iotbits-us/mbox-hardware-mk/docs/README.md

# ModbusBox Hardware For Makers
ModbusBox device hardware design.

### Introduction.

**ModbusBox**    allows the integration of Modbus RTU networks to a WiFi connection. It is capable to  read data registers  from Modbus slaves (tested with 4 )  then send data periodically  to cloud services using the very popular MQTT protocol. Data is serialized  using  Json format , the information can be processed and displayed in dashboards  by many open source IOT platforms like Node-red, Influxdb & Grafana,  Ubidots educational and  its pay platform which is very powerfully and easy to use. 

**ModbusBox**  has been tested and optimized to be connected to  Variable frequency drives that uses  modbus RTU as base protocol , but it can be used with any other device that uses modbus rtu over RS485. protocol .

------

### Hardware features.

**Processor :** ESP32-WROOM-32 

**DC Input :** 7~ 26v ( step down dc buck regulator).

**Current consumption:** <100ma when DC input =20 ~27v

**Hardware interfaces.**

- 1x RS485 port (RJ45), non insolated.
- 1x programing connection (tx0/rx0).
- 1x SPI port.
- 1xI2c port.
- 3x micro buttons for ESP programing mode and device setup.

**Led indication.**

- 1x power led.
- 1 x MQTT activity ( msg send/received).
- 1x  Neopixel  RGB  led for device status indication.
- 1x Modbus TX led.
- 1x Modbus RX led.

**Additional Features**.

- Dc input voltage measurement (voltage divider connected to GPIO35).
- DC input capacitor act as short voltage backup , when  combined with the voltage divider measurement   can be used in the ESP32 program to send  and alarm ( for example an MQTT message )  before the voltage stored in the capacitor reach 3.3 volts.

**WiFi Specs**.

IEEE 802.11 b/g/n

Freq Band: 2.4 ~ 2.462 GHZ.

Integrated Antenna.

------

### PCB  DESING 

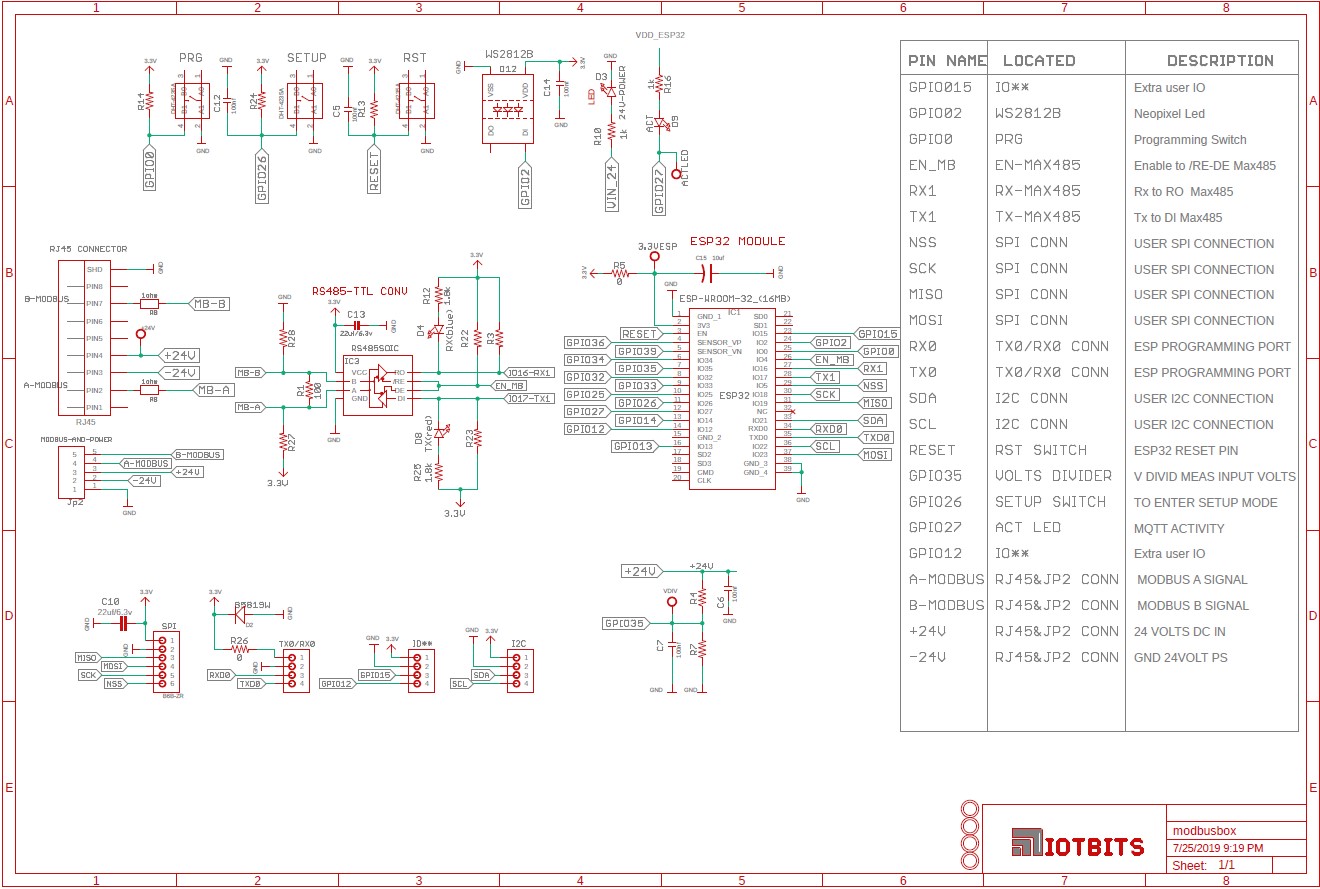
[picture p1: images/mboxschematic.jpg]
Electronic Schematic


[PDF SCHEMATIC](https://github.com/iotbits-llc/mbox-hardware-mk/blob/master/docs/modbusbox.pdf)

**Unassembled top layer  PCB photo**.

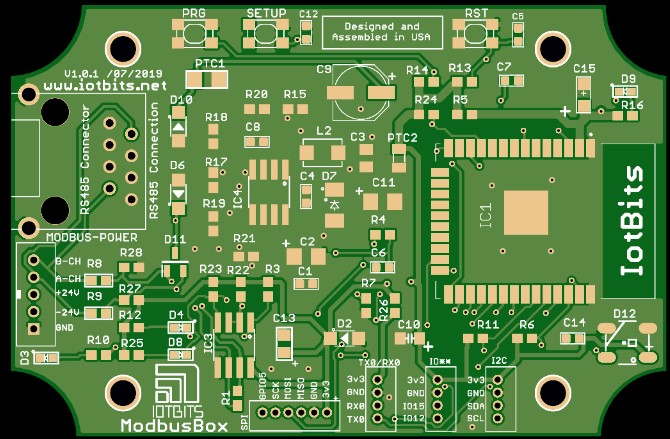
[picture p2: images/tpcb1.jpg]
TOP


**Unassembled bottom  layer  PCB photo**

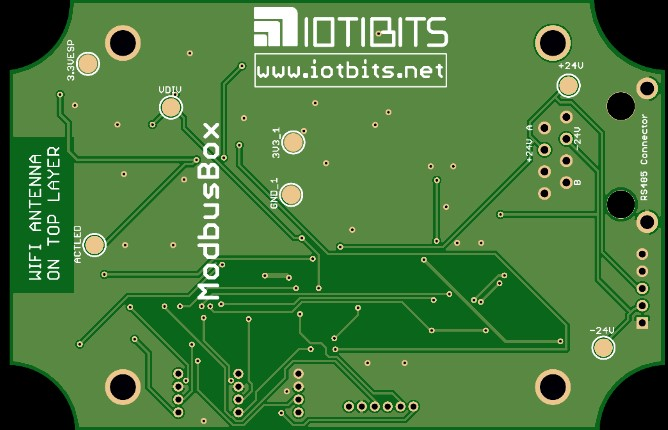
[picture p3: images/bpcb1.jpg]
Bottom


**PCB Photos** 

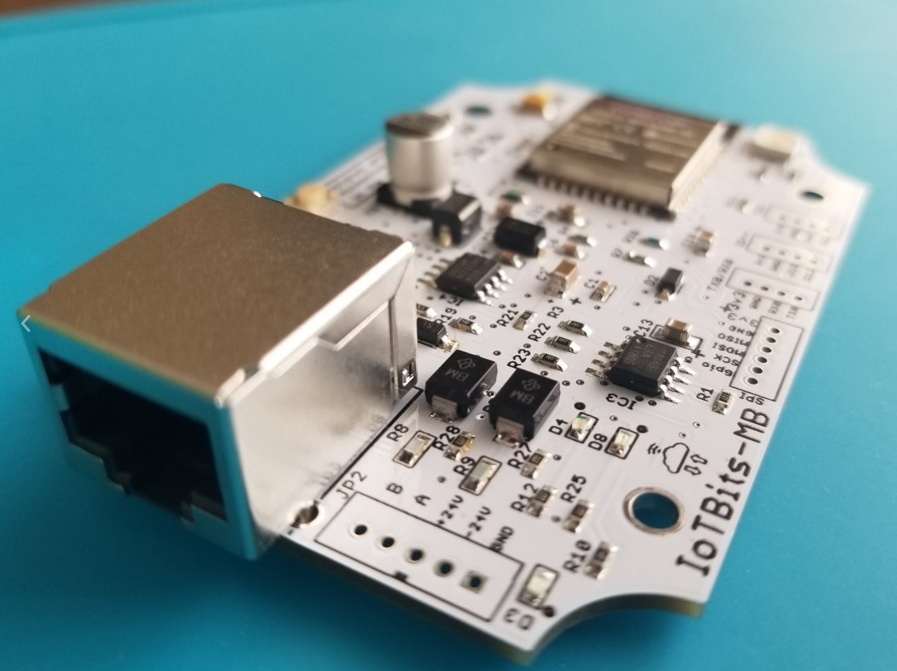
[picture p4: images/mbx2.jpg]
ASSEMBLED PCB


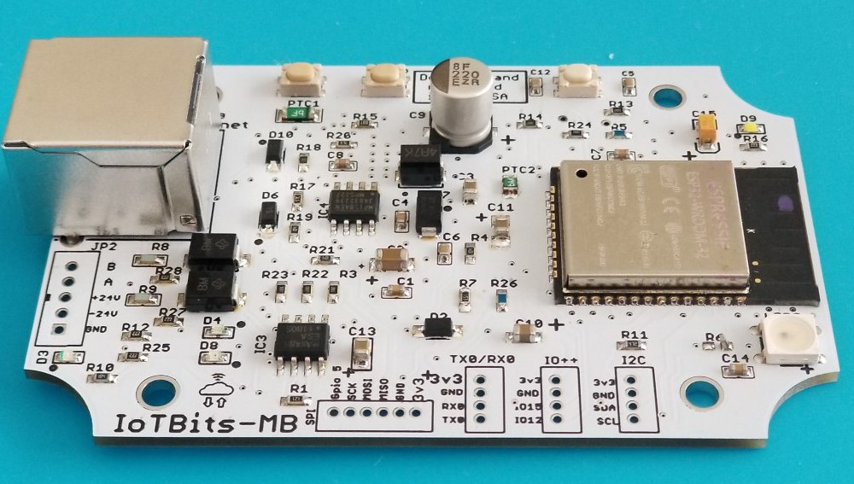
[picture p5: images/mbx3.jpg]


### Modbus  Box Assembled  

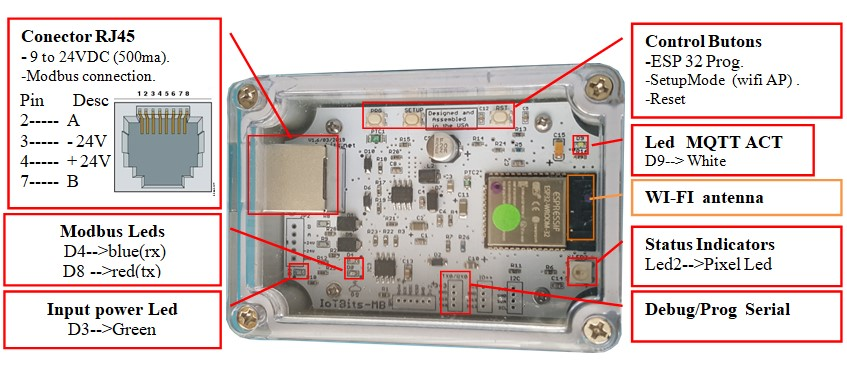
[picture p6: images/Mbox Connector.jpg]


------

###  Modbus Box & ControlTechniques AC drives.

The Modbus Box had been tested successfully  with several AC drives  models of the recognized brad Nidec Control techniques , some of the  drive models tested are : M200/300/400 and C200.  Modbus Box can be connected directly to the drive AI-485 adaptor which also have 24 volts , there is no requirement for additional power supply . An ethernet cable Cat5e  can be used to  make the connection  between the Modbus box and the drive RS485 port.

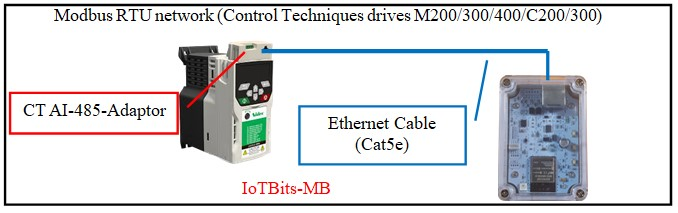
[picture p7: images/Mbox-CT drives.jpg]


------

### Connecting Modbus Box to other Modbus slaves.

In order to connect Modbus box to other Modbus slaves we recommend the following  connecting accessories  that can be found on eBay or Aliexpress.

- RJ45 Female To Screw Terminal 8 Pin Connector :  [ebay link](https://www.ebay.com/itm/RJ45-Female-To-Screw-Terminal-8-Pin-Connector-Ethernet-Cable-Extender-Adapter/254014714403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), [aliexpress link](https://www.aliexpress.com/item/32999037495.html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).
- Ethernet cable Cat6e 0.5m ...50m : [aliexpress link](https://www.aliexpress.com/item/32694241950.html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).
- DC 24 or 12 volts 1 amp  power supply : [aliexpress link ](https://www.aliexpress.com/item/33014882564.html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)

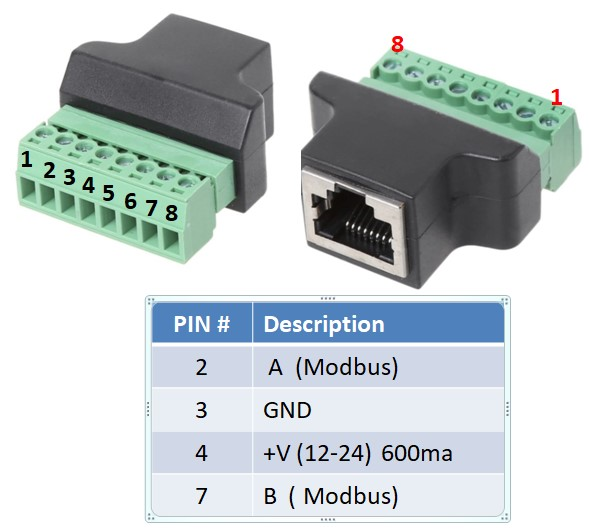
[picture p8: images/Modbus Adaptor.jpg]
RJ45 Female To Screw Terminal


### Connecting Modbus Box to SDM230-Modbus.

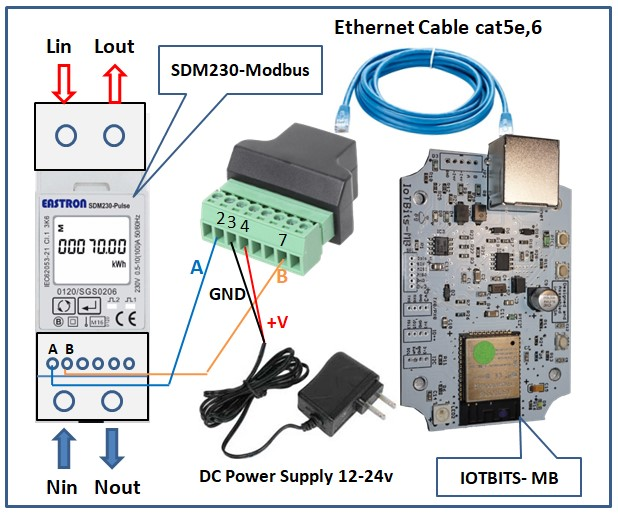
[picture p9: images/SDM230-Modbus.jpg]
SDM230-Modbus


[Library to test the ModbusBox ](https://github.com/luisgcu/SensorModbusMaster)
