iotbits-us/mbox-hardware-mk/images/mbx4.jpg

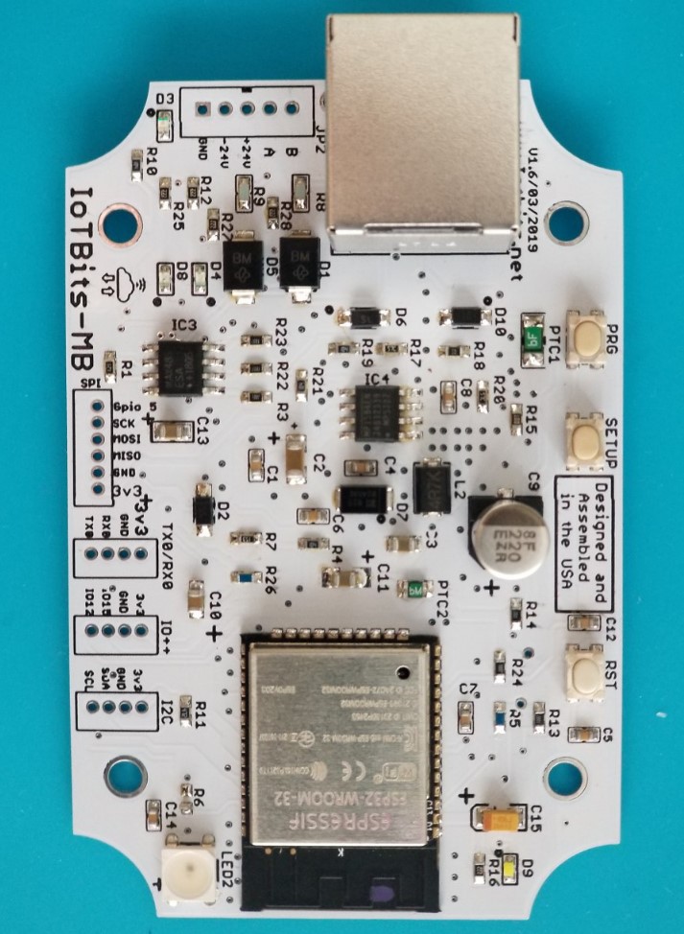
images/mbx4.jpg
