iotbits-us/mbox-hardware-mk/images/ModbusBox.png

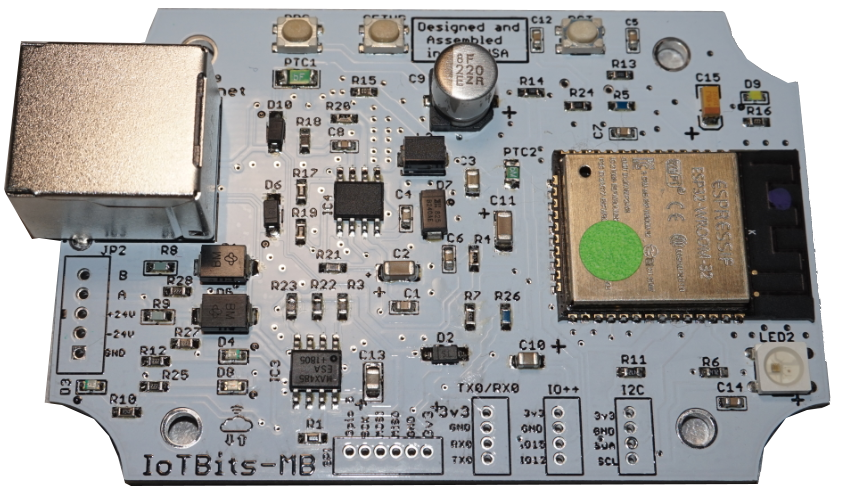
images/ModbusBox.png
