iotbits-us/mbox-hardware-mk/images/tpcb.jpg

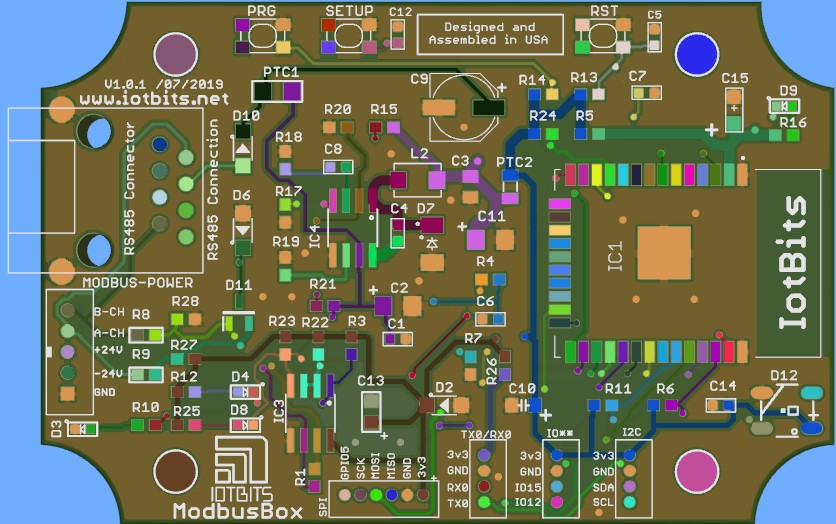
images/tpcb.jpg
