iotbits-us/mbox-hardware-mk/docs/modbusbox.pdf

# GND GND 3.3V GND 3.3V GND 3.3V

# 5 A⁰

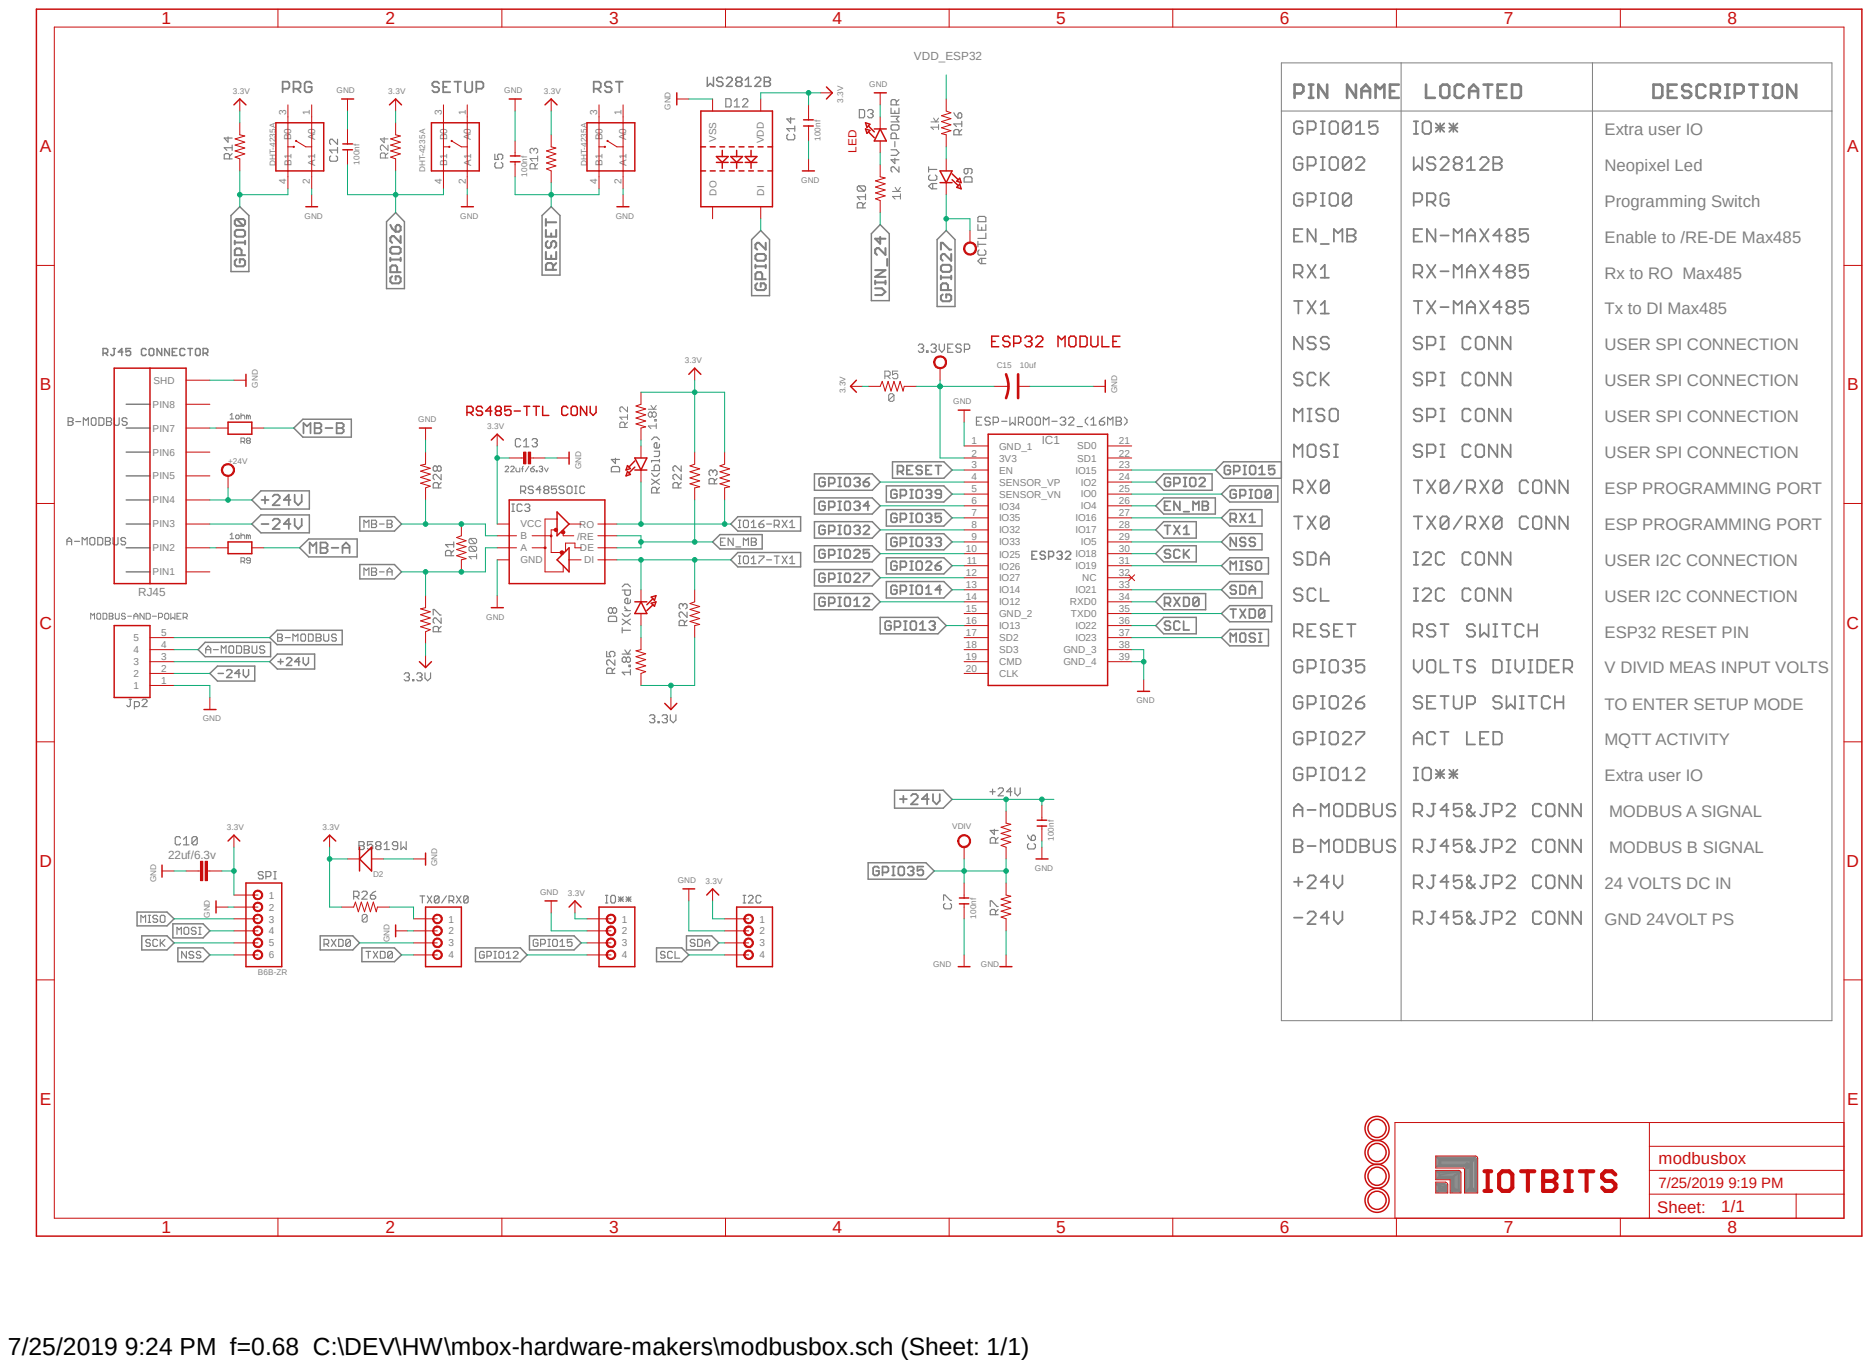
[picture p13: page 1]
GND; 3.3V GND GND; 3.3V GND; 22uf/6.3v GND; GND GND; 3.3V GND DHT⁻4235A; DHT⁻4235A 100nf GND 100nf; GND DHT⁻4235A; 100nf GND 100nf GND; 100nf GND; Neopixel Led; Programming Switch; USER I2C CONNECTION; ESP32 RESET PIN; MQTT ACTIVITY; MODBUS A SIGNAL; MODBUS B SIGNAL; 1 GND 24VOLT PS 2 3 4; DE GND; DI VCC; PIN1 PIN2 PIN3 PIN4 PIN5 PIN6 PIN7 PIN8 RJ45SHD; VSS; VDD DO; VDIV; GND_1 1; SENSOR_VP 4; SENSOR_VN 5; GND_2 15; CMD 19; CLK 20; 33 RXD0; 34 TXD0; 37 GND_3; 38 GND_4; VDD_ESP32 LED; Sheet: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

Extra user IO

Enable to /RE-DE Max485

Rx to RO Max485

Tx to DI Max485

USER SPI CONNECTION

ESP PROGRAMMING PORT

V DIVID MEAS INPUT VOLTS

TO ENTER SETUP MODE

24 VOLTS DC IN

7/25/2019 9:24 PM f=0.68 C:\DEV\HW\mbox-hardware-makers\modbusbox.sch (Sheet: 1/1)
