iotbits-us/mbox-hardware-mk/modbusbox.sch

## EAGLE design modbusbox.sch (2019-07-26)

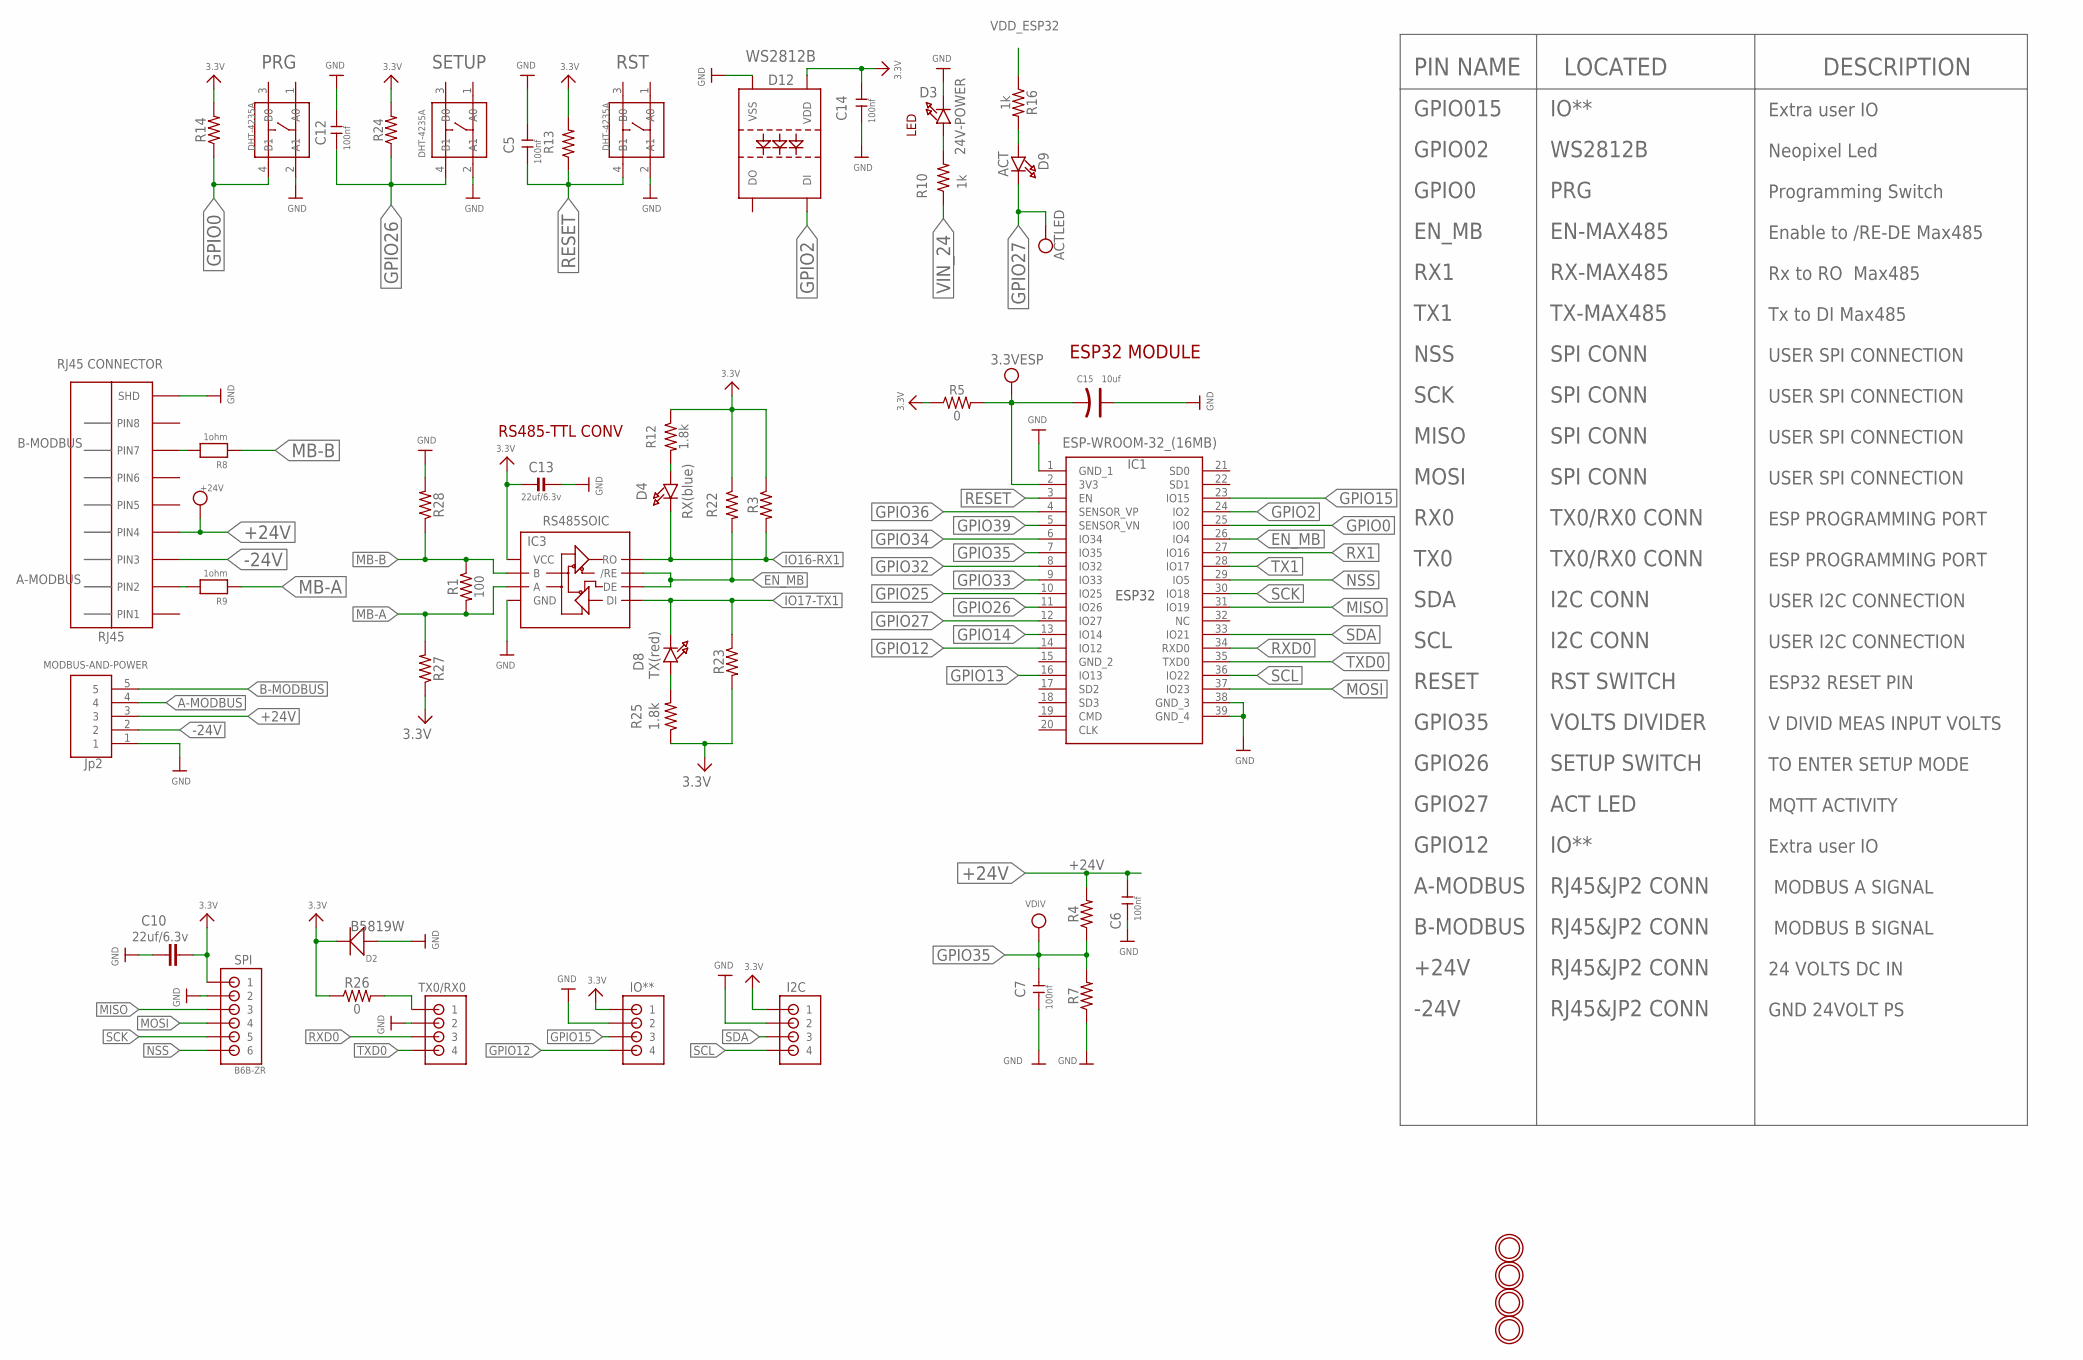
[picture p14: schematic modbusbox.sch]

Parts:
3.3VESP: TESTPOINTROUND2MM; TESTPOINT_ROUND_2MM
+24V: TESTPOINTROUND2MM; TESTPOINT_ROUND_2MM
ACTLED: TESTPOINTROUND2MM; TESTPOINT_ROUND_2MM
C5, C6, C7, C12, C14: 100nf; C0603
C10: 22uf/6.3v; 0805-CAP-LARGEPADS
C13: 22uf/6.3v; _0805
C15: 10uf; AVX-A
D2: B5819W; SOD-123
D3: 24V-POWER; CHIPLED_0603
D4: RX(blue); CHIPLED_0603
D8: TX(red); CHIPLED_0603
D9: ACT; CHIPLED_0603
D12: WS2812B
I2C: B4B-ZR
IC1: ESP-WROOM-32_(16MB); ESP32WROOM32D
IC3: RS485SOIC; SO08
IO**: B4B-ZR
MODBUS-AND-POWER: 5PIN; B5B-PH-K-S
PRG: DHT-4235A; SW4-SMD-4.2X3.2X2.5MM
R1: 100; 0603
R3, R13, R14, R22, R23, R24: 10KOHM-0603-1/10W-1%; 0603
R4: 100k; 0603
R5, R26: 0; 0603
R7: 15k; 0603
R8, R9: 1ohm; 0603
R10, R16: 1k; 0603
R12, R25: 1.8k; 0603
R27, R28: 2.2k; 0603
RJ45: RJ45 CONNECTOR; RJ45
RST: DHT-4235A; SW4-SMD-4.2X3.2X2.5MM
SETUP: DHT-4235A; SW4-SMD-4.2X3.2X2.5MM
SPI: B6B-ZR
TX0/RX0: B4B-ZR
U$30, U$31, U$33, U$35: MOUNTINGHOLE3.0THIN; MOUNTINGHOLE_3.0_PLATEDTHIN
VDIV: TESTPOINTROUND2MM; TESTPOINT_ROUND_2MM

Connections:
3.3V: C10.1, C13.1, C14.2, D2.-, D12.1 (VDD), I2C.1, IC3.8 (VCC), IO**.1, R3.1, R5.1, R12.1, R13.2, R14.2, R22.1, R23.2, R24.2, R25.1, R26.1, R27.1, SPI.1
+24V: +24V.P$1, C6.2, MODBUS-AND-POWER.3, R4.2, RJ45.P$10 (PIN4)
-24V: MODBUS-AND-POWER.2, RJ45.P$9 (PIN3)
A-MODBUS: MODBUS-AND-POWER.4, R9.2, RJ45.P$3 (PIN2)
B-MODBUS: MODBUS-AND-POWER.5, R8.2, RJ45.P$6 (PIN7)
EN_MB: IC1.26 (IO4), IC3.2 (/RE), IC3.3 (DE), R22.2
GND: C5.2, C6.1, C7.1, C10.2, C12.2, C13.2, C14.1, C15.+, D2.+, D3.C, D12.3 (VSS), I2C.2, IC1.1 (GND_1), IC1.38 (GND_3), IC1.39 (GND_4), IC3.5 (GND), IO**.2, MODBUS-AND-POWER.1, PRG.2 (A1), R7.1, R28.2, RJ45.P$1 (SHD), RST.2 (A1), SETUP.2 (A1), SPI.2, TX0/RX0.2
GPIO0: IC1.25 (IO0), PRG.4 (B1), R14.1
GPIO2: D12.4 (DI), IC1.24 (IO2)
GPIO12: IC1.14 (IO12), IO**.4
GPIO13: IC1.16 (IO13)
GPIO14: IC1.13 (IO14)
GPIO15: IC1.23 (IO15), IO**.3
GPIO25: IC1.10 (IO25)
GPIO26: C12.1, IC1.11 (IO26), R24.1, SETUP.4 (B1)
GPIO27: ACTLED.P$1, D9.C, IC1.12 (IO27)
GPIO32: IC1.8 (IO32)
GPIO33: IC1.9 (IO33)
GPIO34: IC1.6 (IO34)
GPIO35: C7.2, IC1.7 (IO35), R4.1, R7.2, VDIV.P$1
GPIO36: IC1.4 (SENSOR_VP)
GPIO39: IC1.5 (SENSOR_VN)
IO16-RX1: D4.C, IC3.1 (RO), R3.2
IO17-TX1: D8.C, IC3.4 (DI), R23.1
MB-A: IC3.6 (A), R1.2, R9.1, R27.2
MB-B: IC3.7 (B), R1.1, R8.1, R28.1
MISO: IC1.31 (IO19), SPI.3
MOSI: IC1.37 (IO23), SPI.4
unnamed: D3.A, R10.2
unnamed: D8.A, R25.2
unnamed: D9.A, R16.2
unnamed: R26.2, TX0/RX0.1
unnamed: D4.A, R12.2
NSS: IC1.29 (IO5), SPI.6
RESET: C5.1, IC1.3 (EN), R13.1, RST.4 (B1)
RX1: IC1.27 (IO16)
RXD0: IC1.34 (RXD0), TX0/RX0.3
SCK: IC1.30 (IO18), SPI.5
SCL: I2C.4, IC1.36 (IO22)
SDA: I2C.3, IC1.33 (IO21)
TX1: IC1.28 (IO17)
TXD0: IC1.35 (TXD0), TX0/RX0.4
VDD_ESP32: 3.3VESP.P$1, C15.-, IC1.2 (3V3), R5.2, R16.1
VIN_24: R10.1

Notes on the sheet:
RS485-TTL CONV
LED
ESP32 MODULE
ESP32
Jp2
RJ45 CONNECTOR
PIN NAME
LOCATED
DESCRIPTION
GPIO015
GPIO02
GPIO0
RX1
TX1
NSS
SCK
MISO
SDA
RX0
TX0
SCL
MOSI
RESET
GPIO35
GPIO26
GPIO27
GPIO12
A-MODBUS
B-MODBUS
+24V
-24V
IO**
WS2812B
PRG
RX-MAX485
TX-MAX485
SPI CONN
I2C CONN
TX0/RX0 CONN
RST SWITCH
VOLTS DIVIDER
SETUP SWITCH
ACT LED
RJ45&JP2 CONN
EN_MB
EN-MAX485
Extra user IO
Neopixel Led
Programming Switch
Enable to /RE-DE Max485
Rx to RO Max485
Tx to DI Max485
USER SPI CONNECTION
ESP PROGRAMMING PORT
USER I2C CONNECTION
ESP32 RESET PIN
V DIVID MEAS INPUT VOLTS
TO ENTER SETUP MODE
MQTT ACTIVITY
MODBUS A SIGNAL
MODBUS B SIGNAL
24 VOLTS DC IN
GND 24VOLT PS
